cclonts2/cclonts2.github.io/docs/second-page.md

---
title: Second Page
---
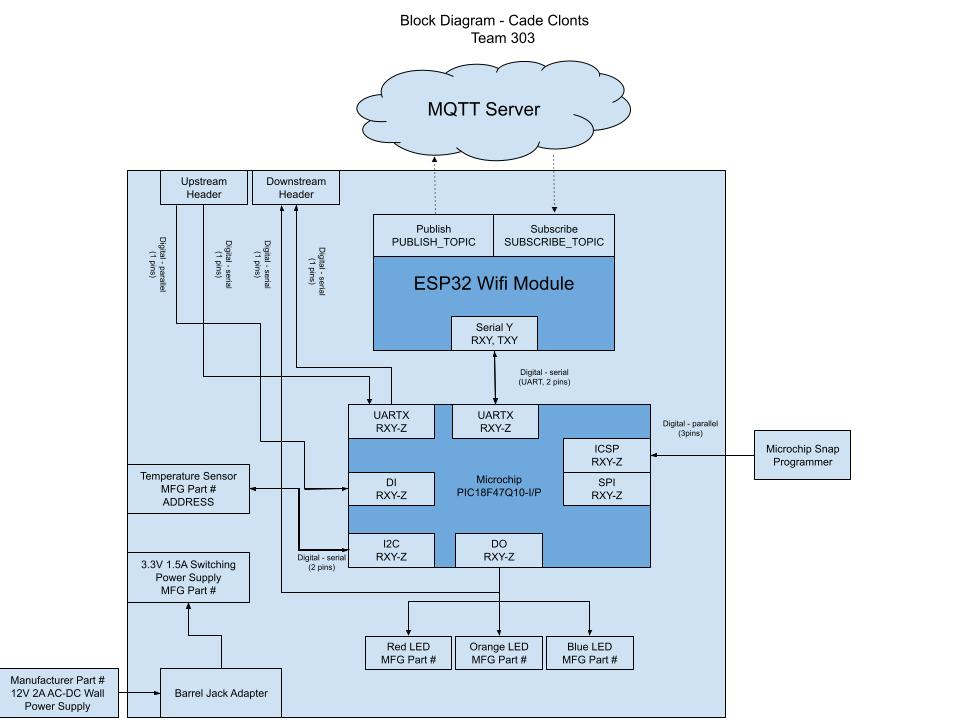
[picture p21: Block Diagram.jpg]
Block Diagram

Things to discuss
