cclonts2/cclonts2.github.io/docs/board-design/EGR314-Schematic.pdf

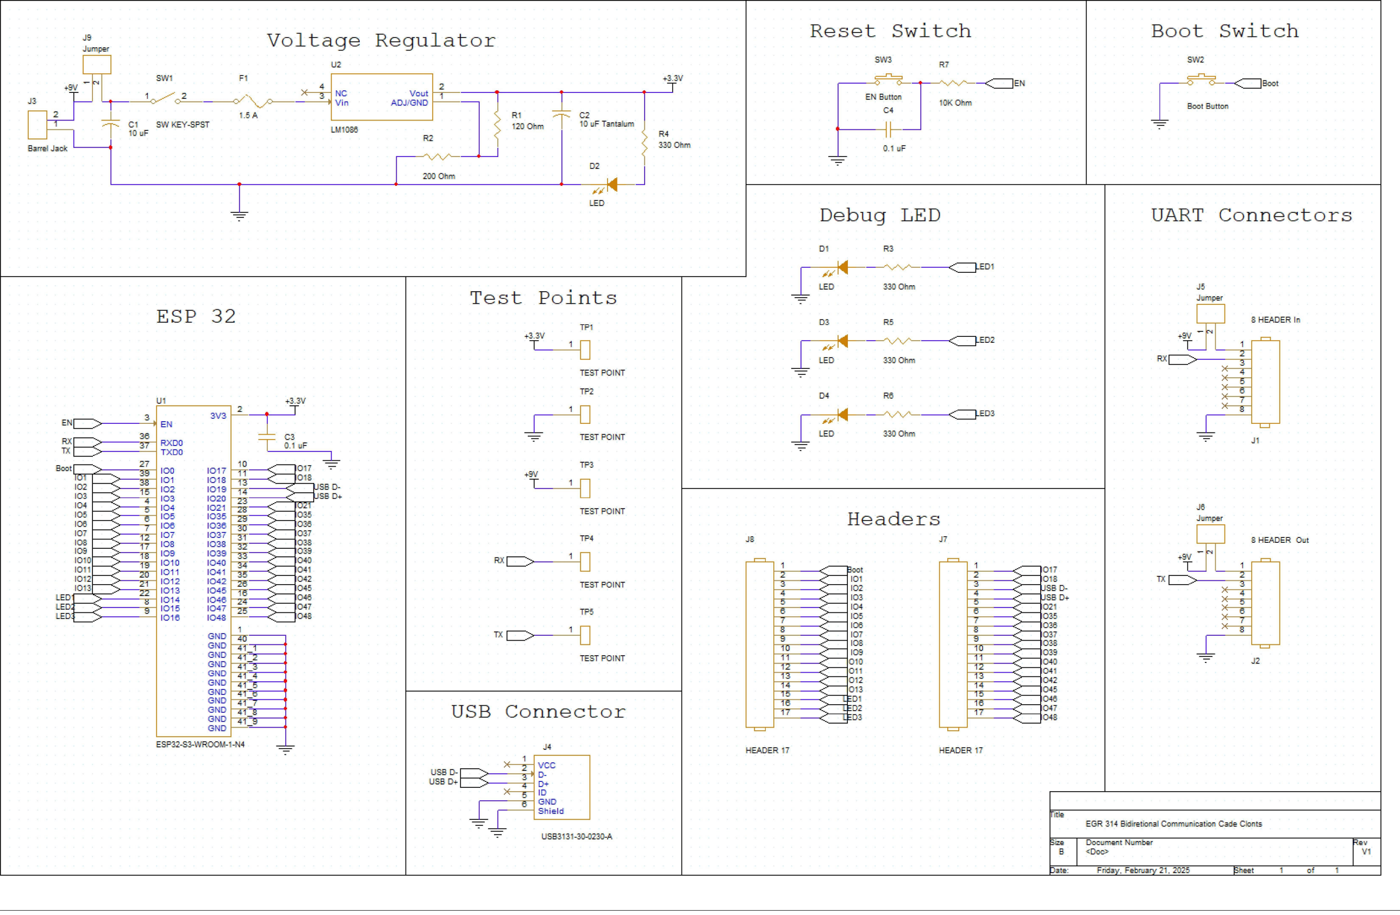
[picture p22: page 1]
