cclonts2/cclonts2.github.io/docs/block-diagram/Block-Diagram-V1-1.png

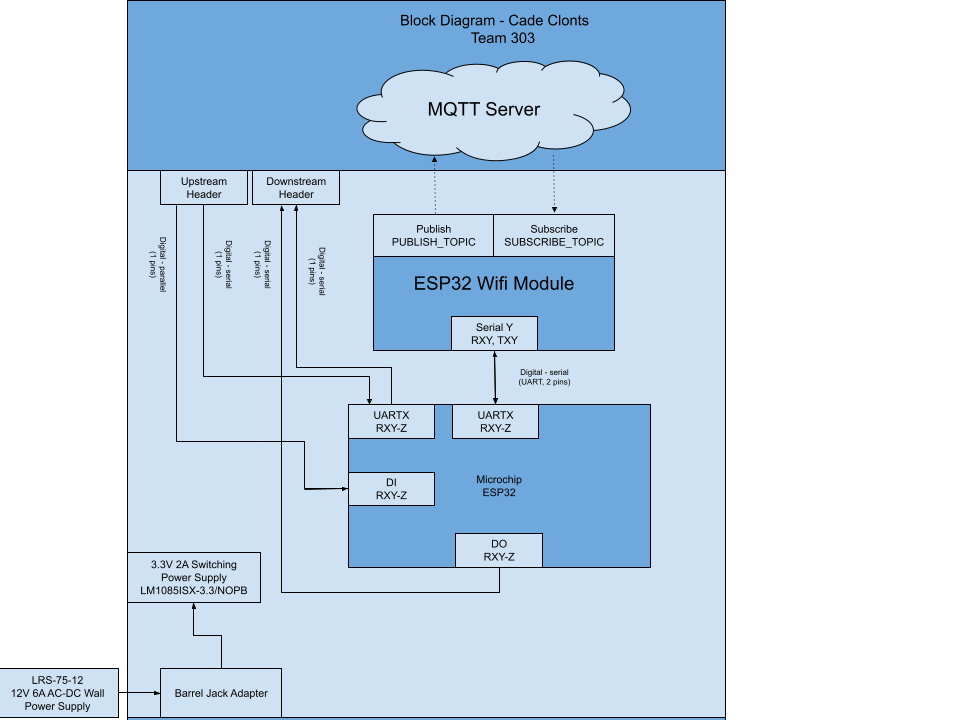
docs/block-diagram/Block-Diagram-V1-1.png
