cclonts2/cclonts2.github.io/docs/board-design/learn-embedded-system-design.jpg

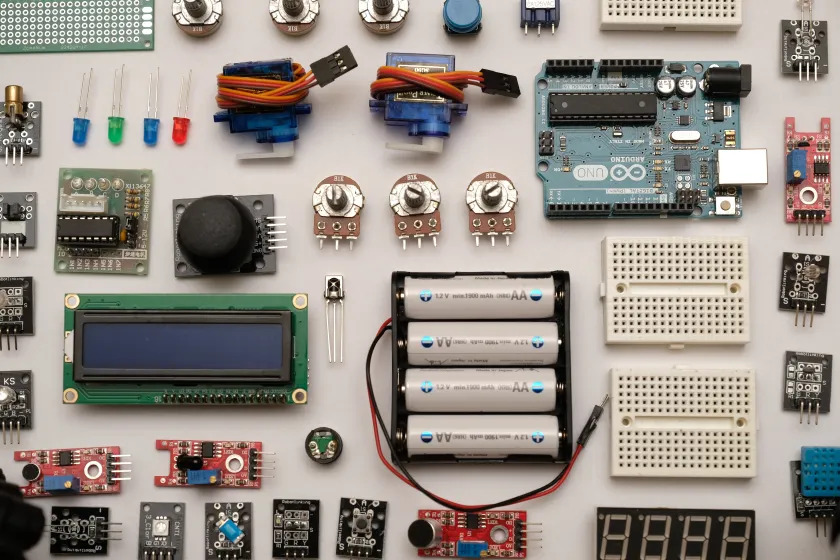
docs/board-design/learn-embedded-system-design.jpg
