cclonts2/cclonts2.github.io/docs/board-design/Schematic-Design.png

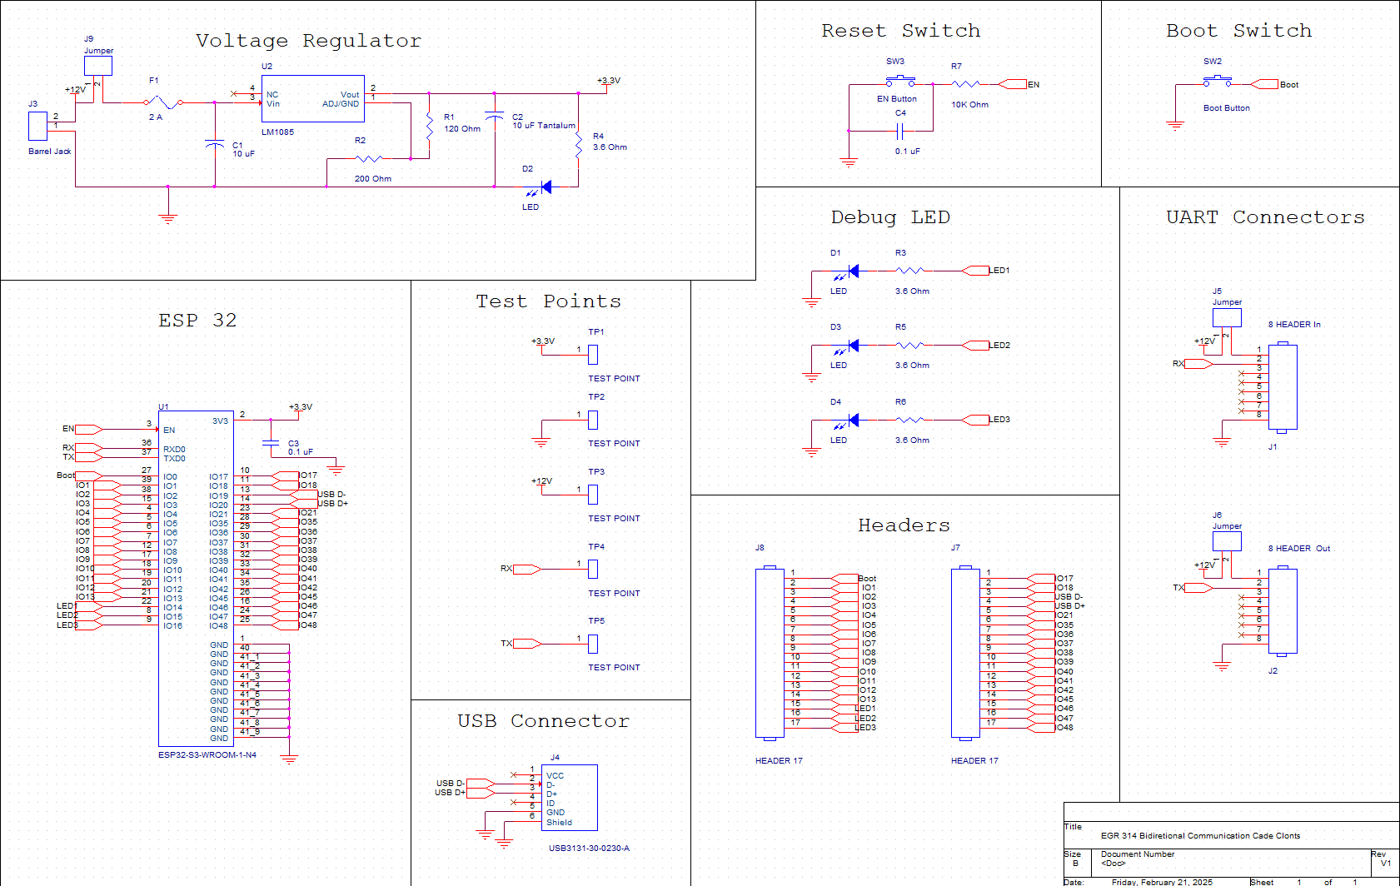
docs/board-design/Schematic-Design.png
