cclonts2/cclonts2.github.io/docs/resources/temp_sense.JPG

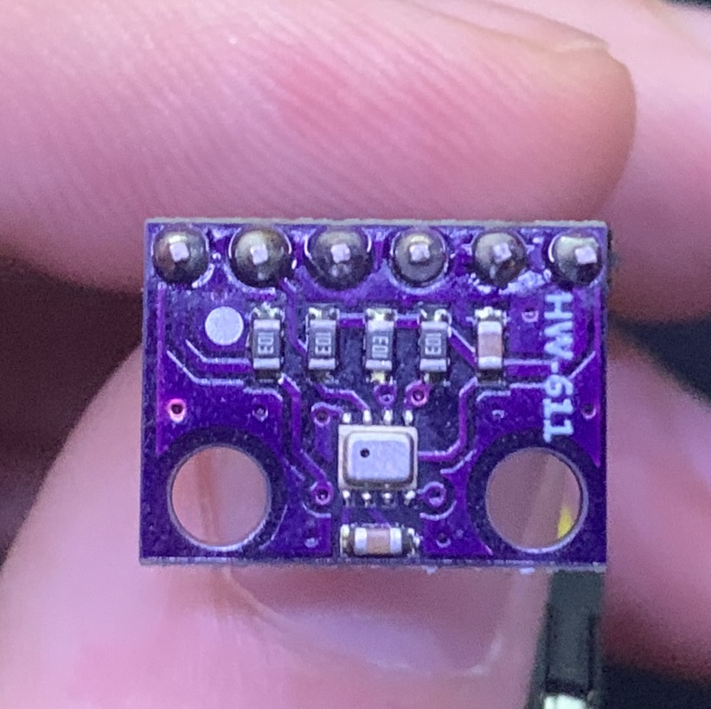
docs/resources/temp_sense.JPG
