cclonts2/cclonts2.github.io/docs/component-selection/index.md

---
title: Component Selection
---

# **Final Components**

## Decision-Making Process & Component Justification

To create this section a structured decision-making process was followed guided by project constraints, performance requirements, cost, and availability. Evaluating each category of components (microcontroller, power regulation, and sensors) by comparing options based on key criteria like functionality, efficiency, ease of integration, and compatibility. Selected final components that not only satisfied technical specifications but also offered reliability and practicality for prototyping and manufacturing.

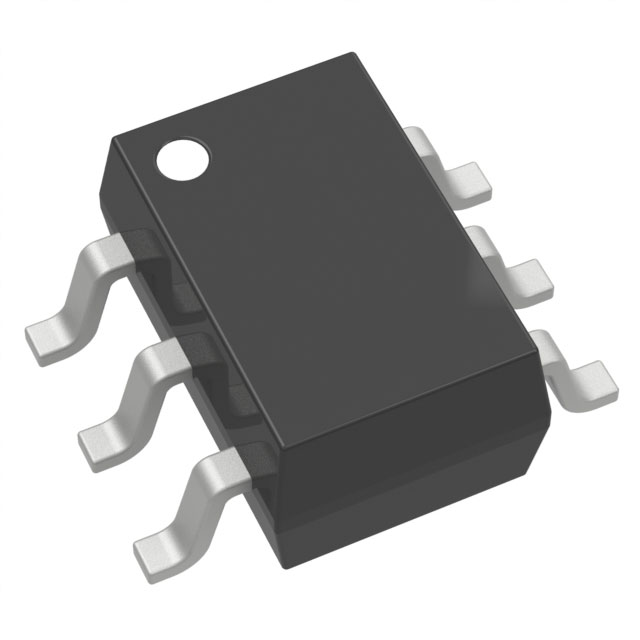
[picture p28: docs/component-selection/ap62300twu-7.jpg]


| **AP62300TWU-7** | **Link** |
|---|---|
| Product Page URL | [DigiKey](https://www.digikey.com/en/products/detail/diodes-incorporated/AP62300TWU-7/12702558) | Found on DigiKey.com |
| LM1086 Datasheet URL | [Datasheet](https://www.diodes.com/assets/Datasheets/AP62300_AP62301_AP62300T.pdf) |

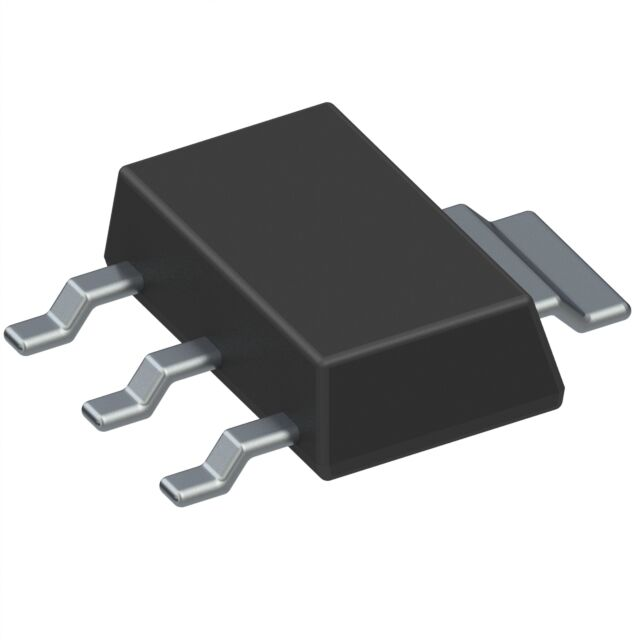
[picture p29: docs/component-selection/ts1117bcw33rpg.jpg]


| **TS1117BCW33 RPG** | **Link** |
|---|---|
| Product Page URL | [DigiKey](https://www.digikey.com/en/products/detail/taiwan-semiconductor-corporation/TS1117BCW33-RPG/7370078) | Found on DigiKey.com |
| LM1086 Datasheet URL | [Datasheet](https://services.taiwansemi.com/storage/resources/datasheet/TS1117B_I2405.pdf) |

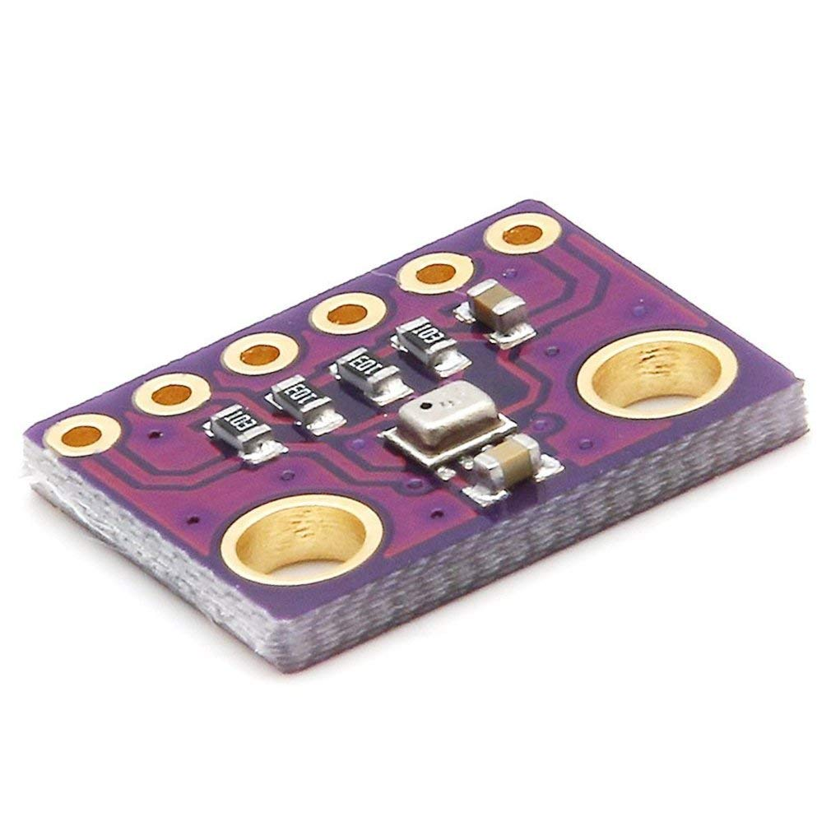
[picture p30: docs/component-selection/bmp280-3.3.jpg]


| **BMP280-3.3** | **Link** |
|---|---|
| Product Page URL | [Amazon](https://www.amazon.com/dp/B07VNDZ6N4?ref=ppx_yo2ov_dt_b_fed_asin_title&th=1) | Found on Amazon.com |
| USB Datasheet URL | [Datasheet](https://www.bosch-sensortec.com/media/boschsensortec/downloads/datasheets/bst-bmp280-ds001.pdf) |

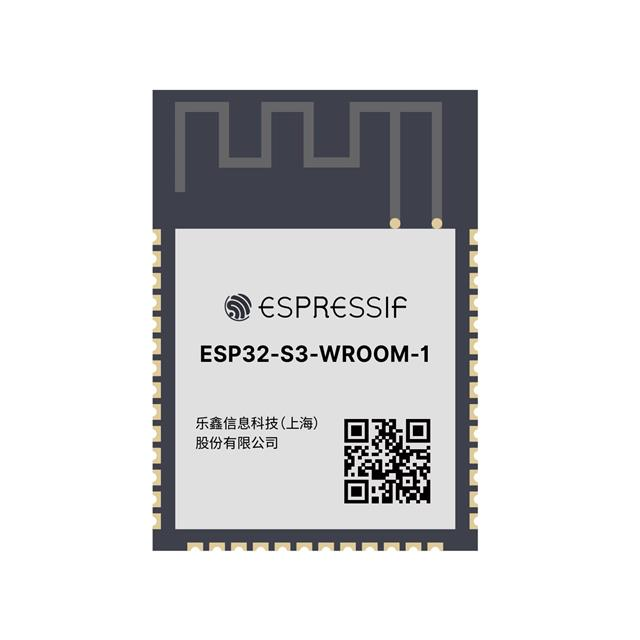
[picture p31: docs/component-selection/MFG_Attachment-2-ESP32-S3-WROOM-1.jpg]


| ESP Info | Answer |
| --- | --- |
| Model | ESP32-S3-WROOM-1-N4 |
| Product Page URL | [Product Page](https://www.digikey.com/en/products/detail/espressif-systems/ESP32-S3-WROOM-1-N4/16162639)|
| ESP32-S3-WROOM-1-N4 Datasheet URL | [Datasheet](https://www.espressif.com/sites/default/files/documentation/esp32-s3-wroom-1_wroom-1u_datasheet_en.pdf)|
| Reference Manual | [Reference Manual](https://www.espressif.com/sites/default/files/documentation/esp32-s3_technical_reference_manual_en.pdf)|
| Vendor link | [Digikey](https://www.digikey.com/en/products/detail/espressif-systems/ESP32-S3-WROOM-1-N4/16162639) |
| Code Examples | [Code Examples](https://github.com/espressif/esp-idf/tree/master/examples) |
| External Resources URL(s) | [External Resources](https://esp32io.com/tutorials/esp32-code-structure) |
| Unit cost | $2.95 |
| Absolute Maximum Current for entire IC | 500mA |
| Supply Voltage Range | 3.0-3.6V |
| Maximum GPIO current (per pin) | 40mA |
| Supports External Interrupts? | Yes |
| Required Programming Hardware, Cost, URL | ESP32-S3 is programmable through USB OTG|

| Module | # Available | Needed | Associated Pins (or * for any) |
| --- | --- | --- | --- |
| Power | 2 | 2 | 3V3, EN |
| Ground | 2 | 2 | GND, GND |
| UART | 3 | 2 |GPIO43 ~ GPIO44, GPIO17 ~ GPIO18|
| External SPI | 4 | 0 | N/A |
| I2C | 2 | 0 | N/A |
| GPIO | 45 | 4 | * |
| ADC | 2 | 0 | N/A |
| LED PWM | 5 | 5 | * |
| Motor PWM | 0 | 0 | N/A |
| USB Programmer | 1 | 1 | GPIO19 ~ GPIO20 |

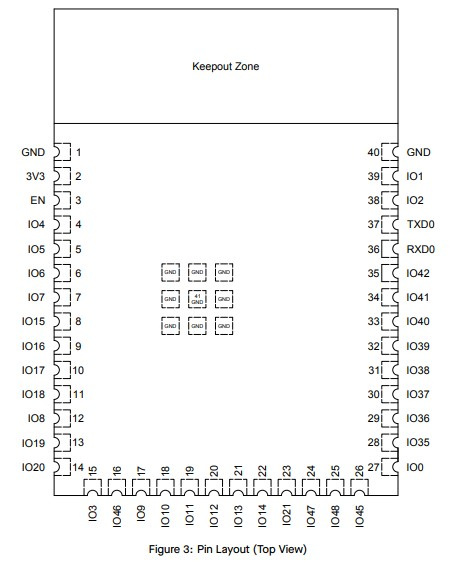
[picture p32: docs/component-selection/ESP32-Pin-Layout.jpg]

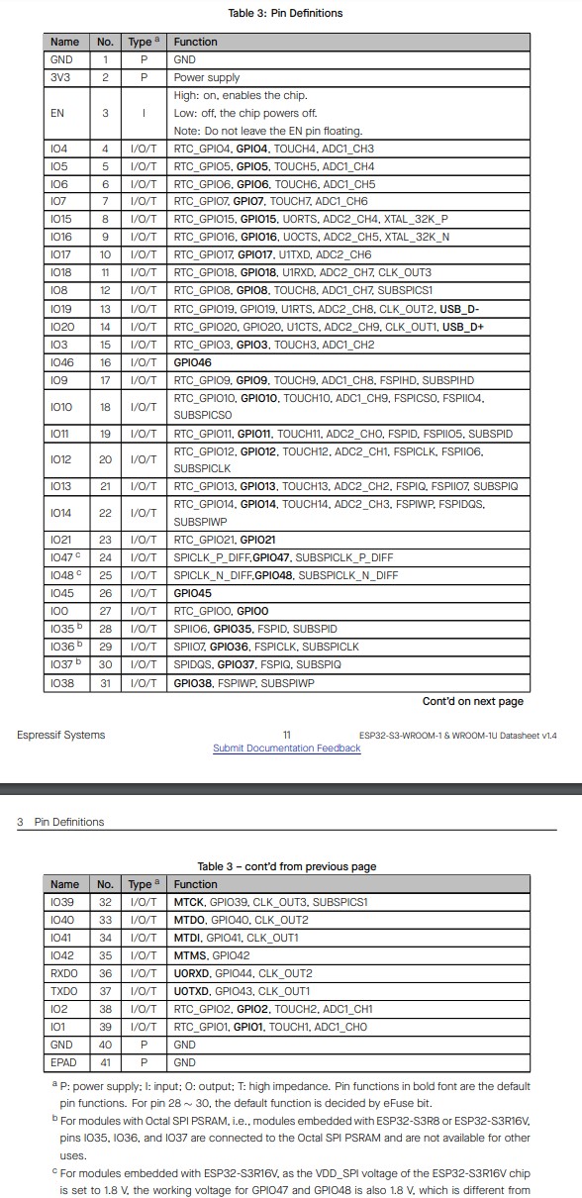
[picture p33: docs/component-selection/ESP32-Pin-Diagram.jpg]


## __Power Budget__

The power budget was developed by identifying all critical system components, specifying their voltage requirements, and estimating their maximum current consumption. Each component on the +3.3V rail was analyzed for its contribution to total current demand.

To account for unexpected current surges or variation in power draw, a 25% safety margin was applied. This results in a final estimated current requirement of:

Total Required Current = 901.12 mA × 1.25 = 1126.4 mA

The selected regulator for the +3.3V rail is the AP62300TWU-7, a high-efficiency buck converter rated for up to 3000 mA output current. This regulator accepts a wide input voltage range (4.2V–18V), making it suitable for use with the chosen external 12V power supply.

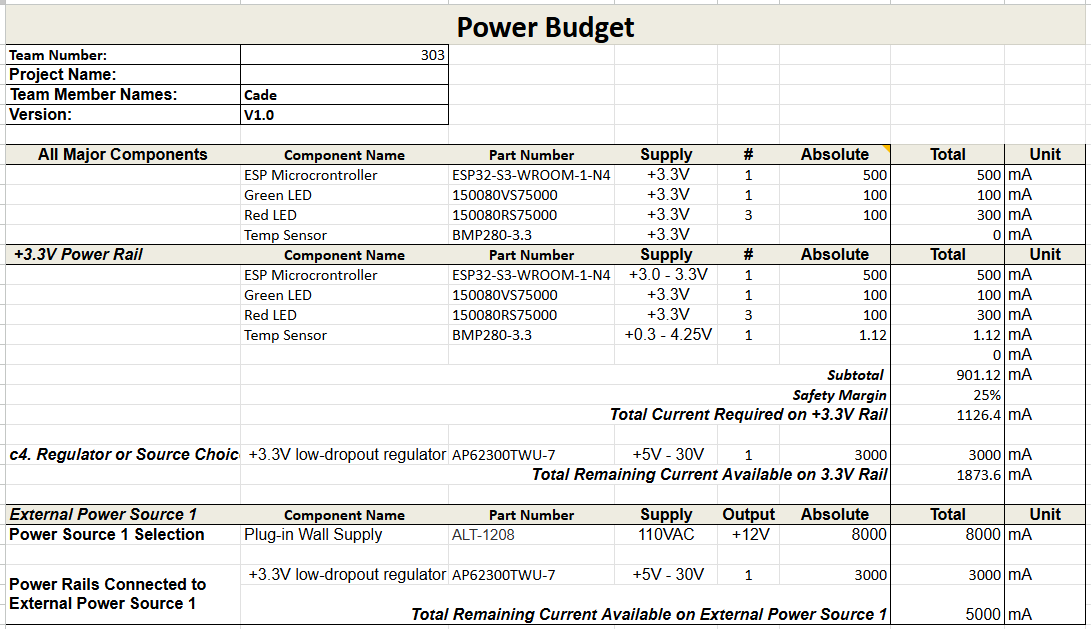
[picture p34: docs/component-selection/power-budget.png]
Power Budget


- [XLSX Files](power-budget.xlsx)

# **Component Selection**

## **Microcontroller**

| **Solution** | **Pros** | **Cons** |
| --- | --- | --- |
| <br>Option 1.<br> **ESP32-S3-WROOM-1-N4** <br>$2.95/each<br>[link to product](https://www.digikey.com/en/products/detail/espressif-systems/ESP32-S3-WROOM-1-N4/16162639) | Versatile <br> Wifi and Bluetooth <br> Meets surface mount constraint of project | No Dedicated SRAM |
| <br> Option 2. <br> ESP32-S3-WROOM-1-N16R8 <br> $3.90/each <br> [Link to product](https://www.digikey.com/en/products/detail/espressif-systems/ESP32-S3-WROOM-1-N16R8/16162642) | 16MB of memory <br> Wifi and Bluetooth |  More expensive <br> Slow shipping speed |
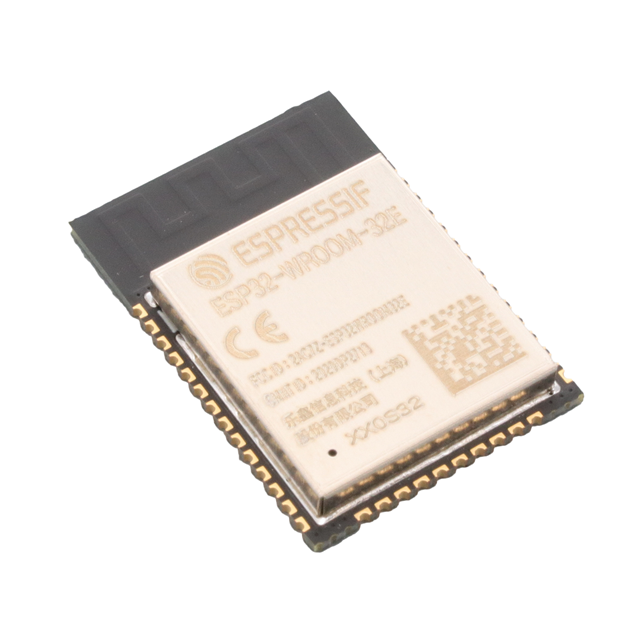
[picture p35: docs/component-selection/MFG_ESP32-WROOM-32E-(4MB-HIGH-TEMP).jpg]
| <br> Option 3. <br> ESP32-WROOM-32E-H4 <br> $2.68/each <br> [Link to product](https://www.digikey.com/en/products/detail/espressif-systems/ESP32-WROOM-32E-H4/12696413) |  Wider operating temperature range <br> Wifi and Bluetooth |  Low Inventory <br> Slow shipping speed |

**Choice:** Option 1: ESP32-S3-WROOM-1-N4.

**Rationale:** The ESP32-S3-WROOM-1-N4 is the optimal choice because it provides a balance of features, cost, and compatibility with the project requirements. Its integrated Wi-Fi and Bluetooth v5.0 capabilities, surface mount design, and sufficient memory make it ideal for bidirectional internet communication. While it has some limitations, such as limited RAM and a moderate operating temperature range, these are not critical for the project.

---

## **Linear Voltage Regulator**

| **Solution** | **Pros** | **Cons** |
| --- | --- | --- |
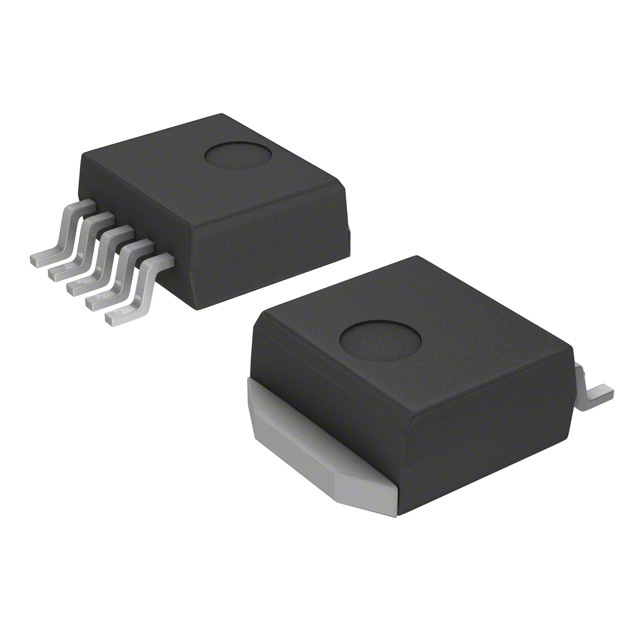
[picture p36: docs/component-selection/DPak-TO-263-5-Leads.jpg]
| <br>Option 1.<br> NCP5662DS33R4G <br>$1.32/each <br> [link to product](https://www.digikey.com/en/products/detail/onsemi/NCP5662DS33R4G/1483762) |Over-Current Protection <br> Enable Pin  | Obsolete Status <br> Bulk Quantity Ordering |
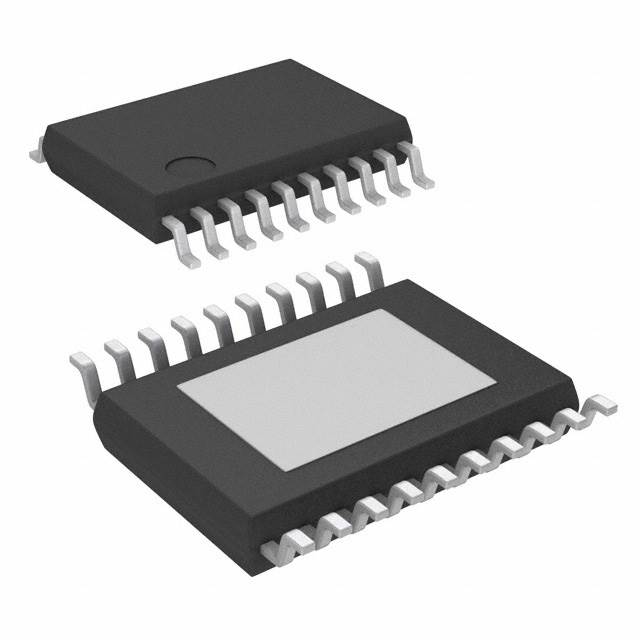
[picture p37: docs/component-selection/296~4073225-4~PWP~20.jpg]
| <br> Option 2. <br> TPS75133QPWPR <br> $4.12/each <br> [Link to product](https://www.digikey.com/en/products/detail/texas-instruments/TPS75133QPWPR/1673042) | Wide Temp Range <br> Advance Features (Reset Pin, etc.) | Low Dropout Voltage <br> Input Voltage 5.5 |
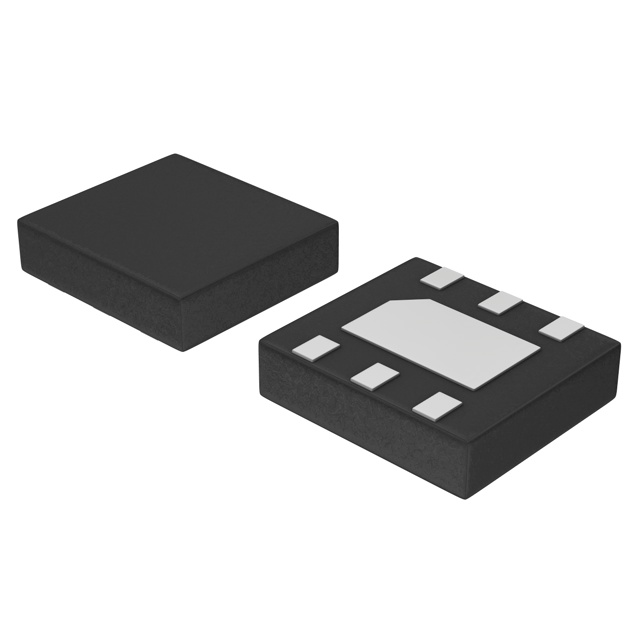
[picture p38: docs/component-selection/488~506AX-01~MN~6.jpg]
| <br> Option 3. <br> NCP565MN33T2G <br> $0.89/each <br> [Link to product](https://www.digikey.com/en/products/detail/onsemi/NCP565MN33T2G/1792550) | Compact Design <br> Wide Temperature Range | Difficult SMD mounting <br> Obsolete Status |
| <br> **Option 4.** <br> AP62300TWU-7 <br> $0.71/each <br> [Link to product](https://www.digikey.com/en/products/detail/diodes-incorporated/AP62300TWU-7/12702558) | Larger Package Size <br> Wide Voltage Input Range (4.2V - 18V) <br> High Efficiency | 85°C Top Temperature |
| <br> **Option 5.** <br> TS1117BCW33 RPG <br> $0.82/each <br> [Link to product](https://www.digikey.com/en/products/detail/taiwan-semiconductor-corporation/TS1117BCW33-RPG/7370078) | Fixed 3.3V Output <br> Simple Design <br> Overcurrent & Thermal Protection <br> | High Dropout Voltage <br> Lower Efficiency |

**Choice:** Option 4 & 5: AP62300TWU-7; TS1117BCW33 RPG

**Rationale:** The combination of the **AP62300TWU-7** and **TS1117BCW33 RPG** provides a versatile power regulation solution. The AP62300TWU-7, a high-efficiency buck converter, efficiently steps down higher input voltages (4.2V - 18V) while delivering up to 3A output current, making it ideal for applications requiring higher power efficiency. However, its switching nature may introduce noise.

The TS1117BCW33 RPG, a low-dropout (LDO) regulator, provides a clean and stable 3.3V output with built-in overcurrent and thermal protection, making it well-suited for noise-sensitive components and 5V PC Programming. Though less efficient than the buck converter, its simplicity and low dropout performance (for lower currents) make it a good secondary choice.

---

## **Temp Sensor**
| **Solution** | **Pros** | **Cons** |
| --- | --- | --- |
| <br>Option 1.<br> BMP280-3.3 <br>$1.48/each <br> [link to product](hhttps://www.amazon.com/dp/B07VNDZ6N4?ref=ppx_yo2ov_dt_b_fed_asin_title&th=1) |Premade <br> Pins for breadboarding <br> Accuracy <br> Multiple Features  | Amazon has no datasheet |
