cclonts2/cclonts2.github.io/docs/board-design/bom.xlsx

Bill of Materials
Part Name/Description | Unit Quantity | Unit Prototype Cost | Total Prototype Cost | Total Order Cost | Manufacturer | Manufacturer Part # | Vendor Link | Datasheet Link | Supplier | Supplier Part # | # Ordered | Date Ordered | # Received | Surplus | Schematic Reference Designators
Capacitor 22uF | 2 | $0.10 | $0.208 | $1.040 | Samsung Electro-Mechanics | CL21A226MAYNNNE | https://www.digikey.com/en/products/detail/samsung-electro-mechanics/CL21A226MAYNNNE/10479857 | https://mm.digikey.com/Volume0/opasdata/d220001/medias/docus/339/CL21A226MAYNNNE_Spec.pdf | Digikey | 1276-CL21A226MAYNNNECT-ND | 10 | 2025-03-17 | 10 | 8 | C2,C6
Capacitor 10uF 0805 | 3 | $0.142 | $0.426 | $2.840 | Murata Electronics | GRM21BR61E106KA73L | https://www.digikey.com/en/products/detail/murata-electronics/GRM21BR61E106KA73L/2334874 | https://search.murata.co.jp/Ceramy/image/img/A01X/G101/ENG/GRM21BR61E106KA73-01.pdf | Digikey | 490-5523-1-ND | 20 | 2025-03-17 | 20 | 17 | C1,C8,C9
Capacitor 0.1uF 0805 | 6 | $0.034 | $0.204 | $1.020 | YAGEO | CC0805KRX7R9BB104 | https://www.digikey.com/en/products/detail/yageo/CC0805KRX7R9BB104/302874 | https://www.yageo.com/upload/media/product/productsearch/datasheet/mlcc/UPY-GPHC_X7R_6.3V-to-250V_24.pdf | Digikey | 311-1140-1-ND | 30 | 2025-03-17 | 30 | 24 | C3,C4,C5,C7,C10,C11
Green LED 0805 | 1 | $0.170 | $0.170 | $1.700 | Würth Elektronik | 150080VS75000 | https://www.digikey.com/en/products/detail/w%C3%BCrth-elektronik/150080VS75000/4489924 | https://www.we-online.com/components/products/datasheet/150080VS75000.pdf | Digikey | 732-4984-1-ND | 10 | 2025-03-17 | 10 | 9 | D1,D2,D3,D4
Red LED 0805 | 3 | $0.170 | $0.510 | $1.700 | Würth Elektronik | 150080RS75000 | https://www.digikey.com/en/products/detail/w%C3%BCrth-elektronik/150080RS75000/4489918 | https://www.we-online.com/components/products/datasheet/150080RS75000.pdf | Digikey | 732-4986-1-ND | 10 | 2025-03-17 | 10 | 7
Diode 0805 | 2 | $0.222 | $0.444 | $2.220 | KYOCERA AVX | SD0805S020S1R0 | https://www.digikey.com/en/products/detail/kyocera-avx/SD0805S020S1R0/3749517 | https://datasheets.kyocera-avx.com/schottky.pdf | Digikey | 478-7800-1-ND | 10 | 2025-03-17 | 10 | 8 | D6,D7
8 Pin header | 2 | $0.950 | $1.900 | $3.800 | Molex | 702460801 | https://www.digikey.com/en/products/detail/molex/0702460801/760165 | https://www.molex.com/en-us/products/part-detail/702460801?display=pdf | Digikey | 900-0702460801-ND | 4 | 2025-03-17 | 4 | 2 | J1,J2
Usb connector | 1 | $0.770 | $0.770 | $0.770 | GCT | USB3131-30-0230-A | https://www.digikey.com/en/products/detail/gct/USB3131-30-0230-A/9859642 | https://gct.co/files/specs/usb3131-spec.pdf | Digikey | 2073-USB3131-30-0230-ACT-ND | 1 | 2025-03-17 | 1 | 0 | J3
Barrel Jack | 1 | $0.690 | $0.690 | $1.380 | Tensility International Corp | 54-00167 | https://www.digikey.com/en/products/detail/tensility-international-corp/54-00167/10459295 | https://tensility.s3.us-west-2.amazonaws.com/uploads/pdffiles/54-00167.pdf | Digikey | 839-54-00167-ND | 2 | 2025-03-17 | 2 | 1 | J4
Jumper Female | 3 | $0.670 | $2.010 | $3.350 | Molex | 15291026 | https://www.digikey.com/en/products/detail/molex/0015291026/315120 | https://www.molex.com/pdm_docs/sd/015291026_sd.pdf | Digikey | 23-0015291026-ND | 5 | 2025-03-17 | 5 | 2 | J5,J6,J7
Jumper Male | 3 | $0.188 | $0.564 | $1.880 | Amphenol CS (FCI) | 68705-102HLF | https://www.digikey.com/en/products/detail/amphenol-cs-fci/68705-102HLF/4403759 | https://cdn.amphenol-cs.com/media/wysiwyg/files/documentation/datasheet/boardwiretoboard/bwb_bergstik.pdf | Digikey | 609-5536-ND | 10 | 2025-03-17 | 10 | 7
Inductor 3.3uH | 1 | $0.267 | $0.267 | $2.670 | TDK Corporation | VLS5045EX-3R3N | https://www.digikey.com/en/products/detail/tdk-corporation/VLS5045EX-3R3N/5286683 | https://product.tdk.com/system/files/dam/doc/product/inductor/inductor/smd/catalog/inductor_commercial_power_vls5045ex_en.pdf | Digikey | 445-174398-1-ND | 10 | 2025-03-17 | 10 | 9 | L1
Resistor 33.2k Ohm 0805 | 1 | $0.025 | $0.025 | $0.250 | Stackpole Electronics Inc | RMCF0805FT33K2 | https://www.digikey.com/en/products/detail/stackpole-electronics-inc/RMCF0805FT33K2/1760489 | https://www.seielect.com/catalog/sei-rmcf_rmcp.pdf | Digikey | RMCF0805FT33K2CT-ND | 10 | 2025-03-17 | 10 | 9 | R1
Resistor 10k Ohm 0805 | 4 | $0.025 | $0.100 | $0.500 | Stackpole Electronics Inc | RMCF0805FT10K0 | https://www.digikey.com/en/products/detail/stackpole-electronics-inc/RMCF0805FT10K0/1760676 | https://www.seielect.com/catalog/sei-rmcf_rmcp.pdf | Digikey | RMCF0805FT10K0CT-ND | 20 | 2025-03-17 | 20 | 16 | R2,R7,R8,R9
Resistor 100 Ohm 0805 | 4 | $0.025 | $0.100 | $0.500 | Stackpole Electronics Inc | RMCF0805FT100R | https://www.digikey.com/en/products/detail/stackpole-electronics-inc/RMCF0805FT100R/1760711 | https://www.seielect.com/catalog/sei-rmcf_rmcp.pdf | Digikey | RMCF0805FT100RCT-ND | 20 | 2025-03-17 | 20 | 16 | R3,R4,R5,R6
Switch | 3 | $1.000 | $3.000 | $6.000 | Omron Electronics Inc-EMC Div | B3U-1000P | https://www.digikey.com/en/products/detail/omron-electronics-inc-emc-div/B3U-1000P/1534338 | https://omronfs.omron.com/en_US/ecb/products/pdf/en-b3u.pdf | Digikey | SW1020CT-ND | 6 | 2025-03-17 | 6 | 3 | SW1,SW2,SW3
Test Points | 5 | $0.293 | $1.465 | $2.930 | Keystone Electronics | 5006 | https://www.digikey.com/en/products/detail/keystone-electronics/5006/255330 | https://www.keyelco.com/userAssets/file/M65p56.pdf | Digikey | 36-5006-ND | 10 | 2025-03-17 | 10 | 5 | TP1,TP2,TP3,TP4,TP5
ESP32 | 1 | $5.060 | $5.060 | $10.120 | Espressif Systems | ESP32-S3-WROOM-1-N4 | https://www.digikey.com/en/products/detail/espressif-systems/ESP32-S3-WROOM-1-N4/16162639 | https://www.espressif.com/sites/default/files/documentation/esp32-s3-wroom-1_wroom-1u_datasheet_en.pdf | Digikey | 1965-ESP32-S3-WROOM-1-N4CT-ND | 2 | 2025-03-17 | 2 | 1 | U1
Voltage Reg 5v-3v | 1 | $0.490 | $0.490 | $4.900 | Taiwan Semiconductor Corporation | TS1117BCW33 RPG | https://www.digikey.com/en/products/detail/taiwan-semiconductor-corporation/TS1117BCW33-RPG/7370078 | https://services.taiwansemi.com/storage/resources/datasheet/TS1117B_I2405.pdf | Digikey | 1801-TS1117BCW33RPGCT-ND | 10 | 2025-03-17 | 10 | 9 | U2
Voltage Reg 12v-3v | 1 | $0.422 | $0.422 | $4.220 | Diodes Incorporated | AP62300TWU-7 | https://www.digikey.com/en/products/detail/diodes-incorporated/AP62300TWU-7/12702558 | https://www.diodes.com/assets/Datasheets/AP62300_AP62301_AP62300T.pdf | Digikey | 31-AP62300TWU-7CT-ND | 10 | 2025-03-17 | 10 | 9 | VR1
Fuse Holder | 1 | $0.810 | $0.810 | $0.810 | Keystone Electronics | 4628 | https://www.digikey.com/en/products/detail/keystone-electronics/4628/2137316 | https://www.keyelco.com/userAssets/file/M65p44.pdf | Digikey | 36-4628-ND | 1 | 2025-03-17 | 1 | 0
Power Supply | 1 | $18.990 | $18.990 | $18.990 | ALITOVE | ALT-1208 | https://www.amazon.com/ALITOVE-Converter-Transformer-5-5x2-1mm-Computer/dp/B07G5BQGYD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 |  | Amazon | ALT-1208 | 1 |  | 1 | 0
Temperature Sensor | 1 |  |  | $0.000 | HiLetgo | B07VNDZ6N4 | https://www.amazon.com/dp/B07VNDZ6N4?ref=ppx_yo2ov_dt_b_fed_asin_title&th=1 | https://www.bosch-sensortec.com/media/boschsensortec/downloads/datasheets/bst-bmp280-ds001.pdf | Amazon | BMP280-3.3 | 1 |  | 1
Ribbon Cable | 8 | $0.960 | $7.680 | $0.000 |  |  | https://www.amazon.com/gp/product/B07DFBPZLJ?smid=A64W1E1ZZHST0 |  | Amazon |  |  |  | 0 | -8
Fuse 2A | 1 | $0.000 | $0.000 | $0.000 |  |  | https://www.digikey.com/en/products/detail/optifuse/TCC-2A/12090267 | https://www.optifuse.com/optifuse_ecommerce_tools/datasheets/TCC.pdf | Digikey |  |  |  | 0 | -1 | F1
Header pins 18 | 2 | $0.000 | $0.000 | $0.000 |  |  |  |  | Digikey |  |  |  | 0 | -2 | J8,J9
 | TOTAL | $32.48 | $46.30 | $73.59
