cclonts2/cclonts2.github.io/docs/component-selection/Power Budget.xlsx

Power Budget
Team Number: | 303
Project Name:
Team Member Names: | Cade
Version: | V1.0
All Major Components | Component Name | Part Number | Supply Voltage Range | # | Absolute Maximum Current (mA) | Total Current (mA) | Unit
 | ESP Microcrontroller | ESP32-S3-WROOM-1-N4 | +3.3V | 1 | 500 | 500 | mA
 | Green LED | 150080VS75000 | +3.3V | 1 | 100 | 100 | mA
 | Red LED | 150080RS75000 | +3.3V | 3 | 100 | 300 | mA
 | Temp Sensor | BMP280-3.3 | +3.3V |  |  | 0 | mA
+3.3V Power Rail | Component Name | Part Number | Supply Voltage Range | # | Absolute Maximum Current (mA) | Total Current (mA) | Unit
 | ESP Microcrontroller | ESP32-S3-WROOM-1-N4 | +3.0 - 3.3V | 1 | 500 | 500 | mA
 | Green LED | 150080VS75000 | +3.3V | 1 | 100 | 100 | mA
 | Red LED | 150080RS75000 | +3.3V | 3 | 100 | 300 | mA
 | Temp Sensor | BMP280-3.3 | +0.3 - 4.25V | 1 | 1.12 | 1.12 | mA
 |  |  |  |  |  | 0 | mA
 | Subtotal |  |  |  |  | 901.12 | mA
 | Safety Margin |  |  |  |  | 25%
 | Total Current Required on +3.3V Rail |  |  |  |  | 1126.4 | mA
c4. Regulator or Source Choice | +3.3V low-dropout regulator | AP62300TWU-7 | +5V - 30V | 1 | 3000 | 3000 | mA
 | Total Remaining Current Available on 3.3V Rail |  |  |  |  | 1873.6 | mA
External Power Source 1 | Component Name | Part Number | Supply Voltage Range | Output Voltage | Absolute Maximum Current (mA) | Total Current (mA) | Unit
Power Source 1 Selection | Plug-in Wall Supply | ALT-1208 | 110VAC | +12V | 8000 | 8000 | mA
Power Rails Connected to External Power Source 1 | +3.3V low-dropout regulator | AP62300TWU-7 | +5V - 30V | 1 | 3000 | 3000 | mA
 | Total Remaining Current Available on External Power Source 1 |  |  |  |  | 5000 | mA
