cclonts2/cclonts2.github.io/docs/board-design/bom.png

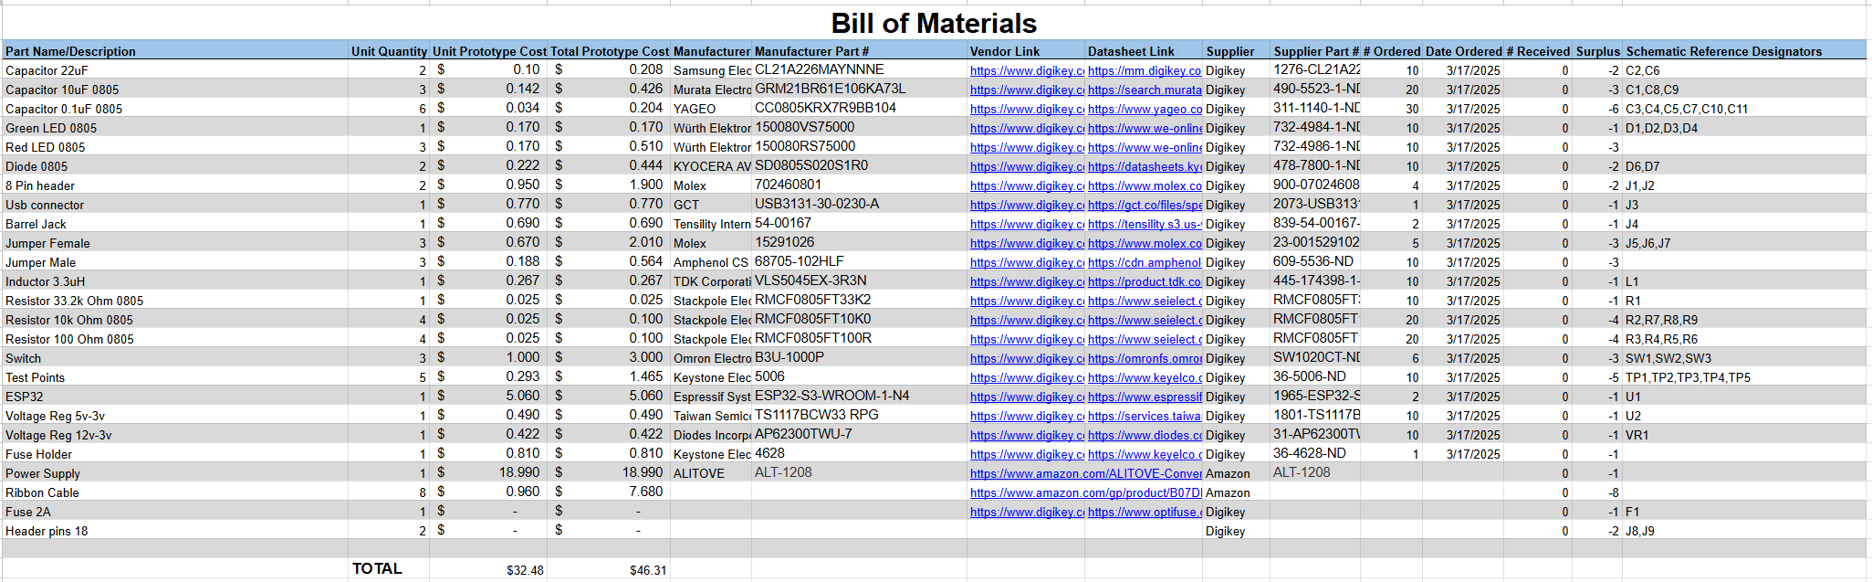
docs/board-design/bom.png
