cclonts2/cclonts2.github.io/docs/component-selection/10118192-0002LF.jpg

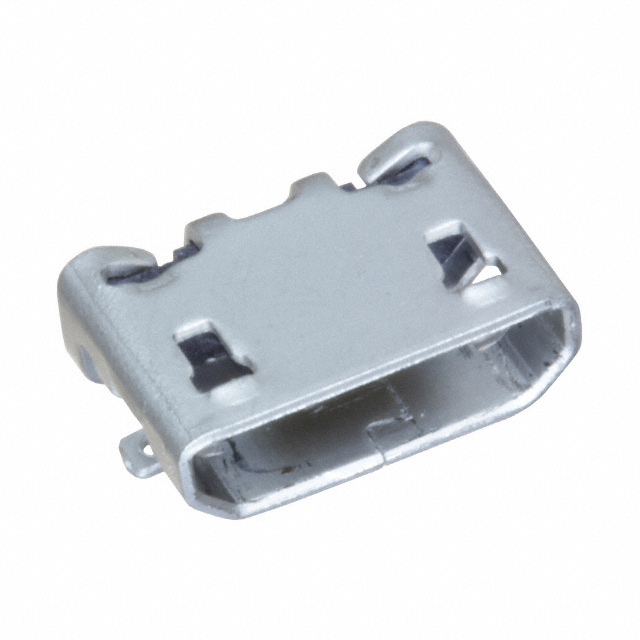
docs/component-selection/10118192-0002LF.jpg
