cclonts2/cclonts2.github.io/docs/component-selection/10118193-0001LF.jpg

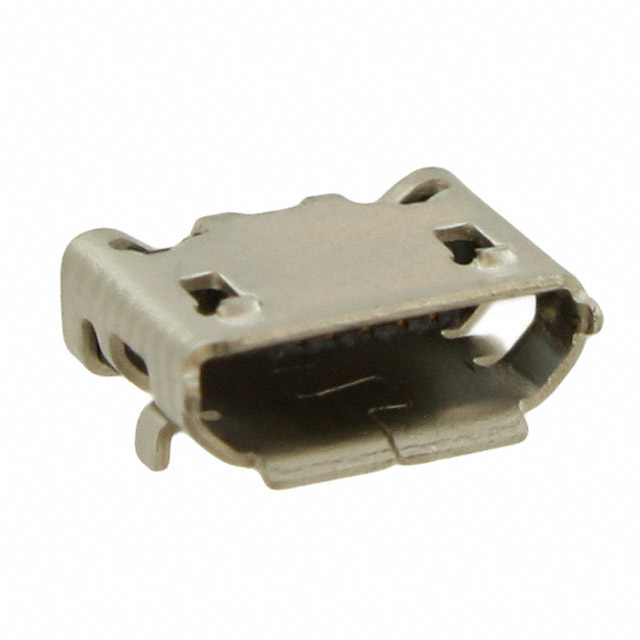
docs/component-selection/10118193-0001LF.jpg
