cclonts2/cclonts2.github.io/docs/component-selection/MFG_USB3140-30-0170-1-C.jpg

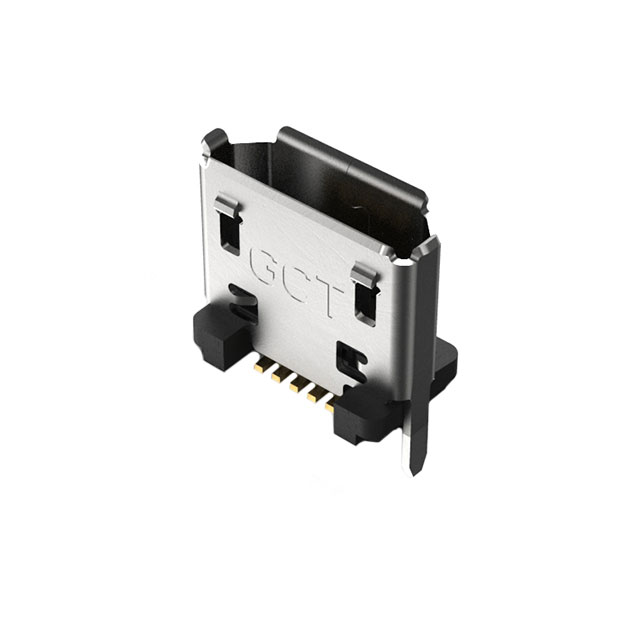
docs/component-selection/MFG_USB3140-30-0170-1-C.jpg
