cclonts2/cclonts2.github.io/docs/resources/top-board-case.step

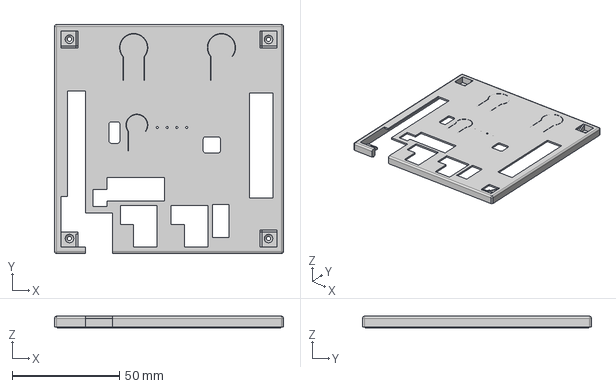
[picture p43: CAD file, 2025-05-06]
docs/resources/top-board-case.step
107.0 x 107.0 x 5.50 mm
