cclonts2/cclonts2.github.io/docs/resources/EGR314-wifi-board.step

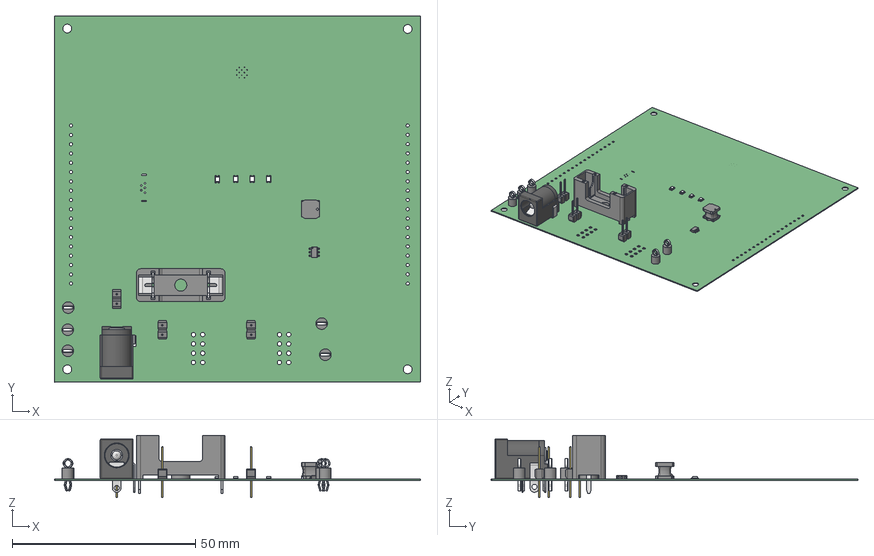
[picture p44: CAD file, 2025-05-06]
docs/resources/EGR314-wifi-board.step
100.0 x 100.2 x 17.1 mm
housing x 4
cover x 4
base_2 x 4
base x 4
marking x 4
