cclonts2/cclonts2.github.io/docs/resources/fun_upper_stand.step

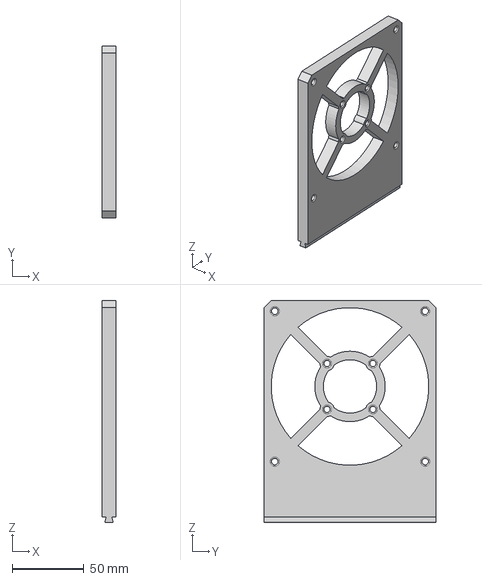
[picture p45: CAD file, 2025-05-06]
docs/resources/fun_upper_stand.step
10.0 x 120.0 x 155.0 mm
Sensor Stand
Fan Stand
