cclonts2/cclonts2.github.io/docs/resources/temperature_stand.step

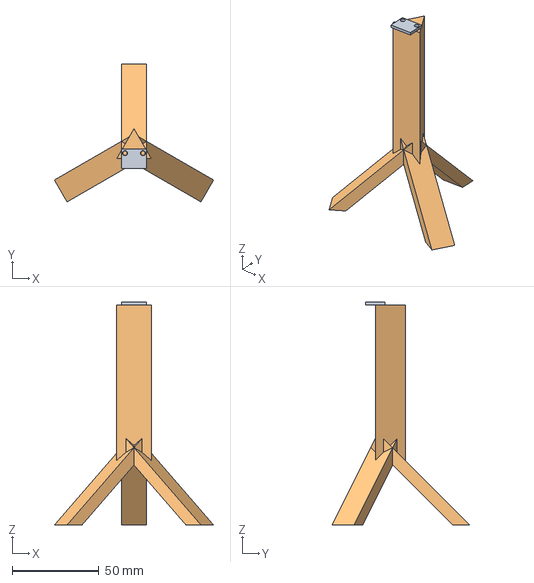
[picture p46: CAD file, 2025-05-06]
docs/resources/temperature_stand.step
91.9 x 79.6 x 128.7 mm
