cclonts2/cclonts2.github.io/docs/resources/fan_lower_stand.step

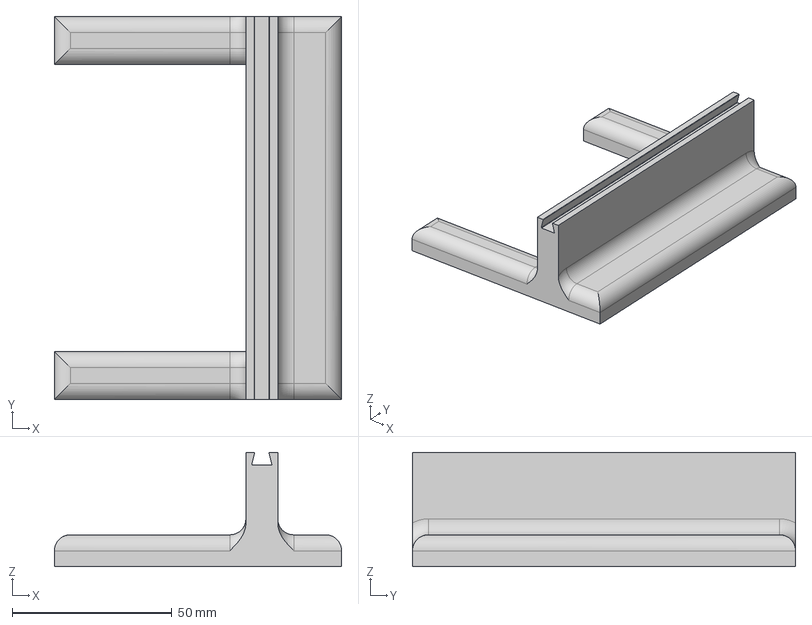
[picture p47: CAD file, 2025-05-06]
docs/resources/fan_lower_stand.step
90.0 x 120.0 x 35.8 mm
Sensor Stand
Fan Stand
