cclonts2/cclonts2.github.io/docs/resources/lower-board-case.step

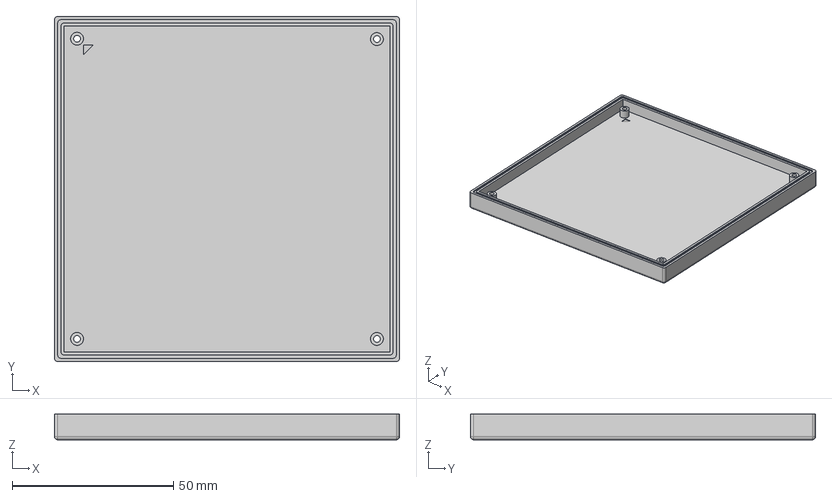
[picture p48: CAD file, 2025-05-06]
docs/resources/lower-board-case.step
107.0 x 107.0 x 8.00 mm
