cclonts2/cclonts2.github.io/docs/resources/heat_lamp_stand.step

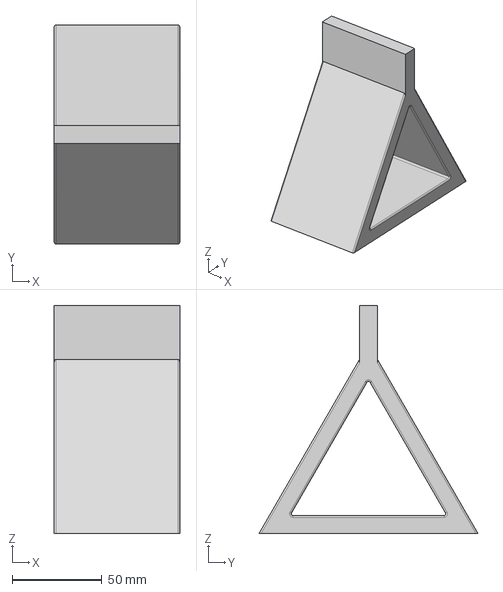
[picture p49: CAD file, 2025-05-06]
docs/resources/heat_lamp_stand.step
70.0 x 122.0 x 127.0 mm
Sensor Stand
Heat Lamp Stand
