cclonts2/cclonts2.github.io/(commit log)

2025-02-08 Create ESP32 Table
2025-02-09 Rename ESP32 Table to ESP32 Table.md
2025-02-09 Create ESP32 Table.md
2025-02-09 Update ESP32 Table.md
2025-02-09 Rename ESP32 Table.md to index.md
2025-03-01 Update Index.md
    Added power budget
2025-03-01 Update Index.md
    Added Bill of Materials
2025-05-06 Rename Power Budget.xlsx to power-budget.xlsx
    [power-budget.xlsx]
