cclonts2/cclonts2.github.io/docs/resources/IMG_7670.JPG

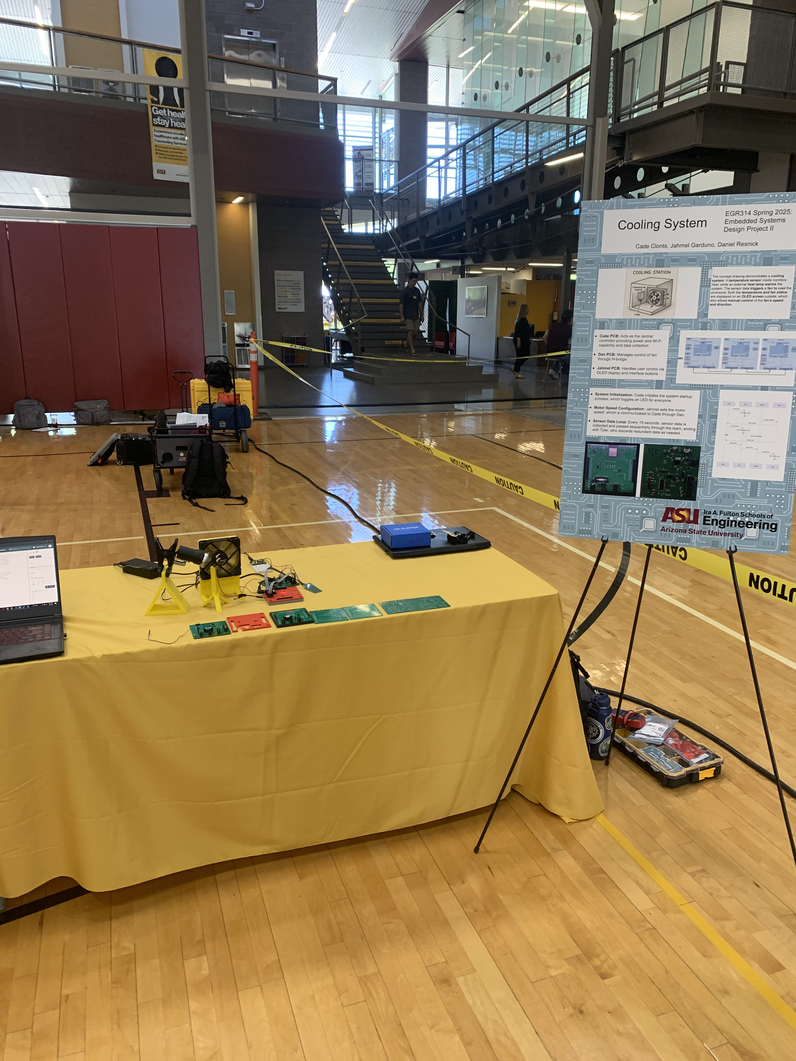
docs/resources/IMG_7670.JPG
